rodrigo-olaya/smart-home-stm32/hardware/stm32_carrier_board/fab/render_bottom.png

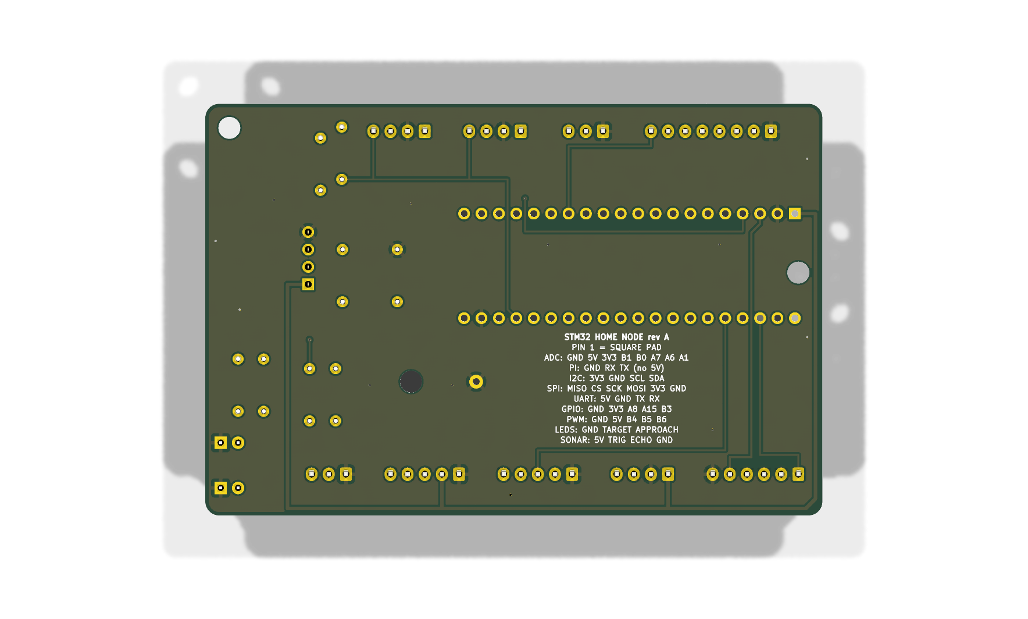
hardware/stm32_carrier_board/fab/render_bottom.png
