rodrigo-olaya/smart-home-stm32/hardware/stm32_carrier_board/fab/render_top.png

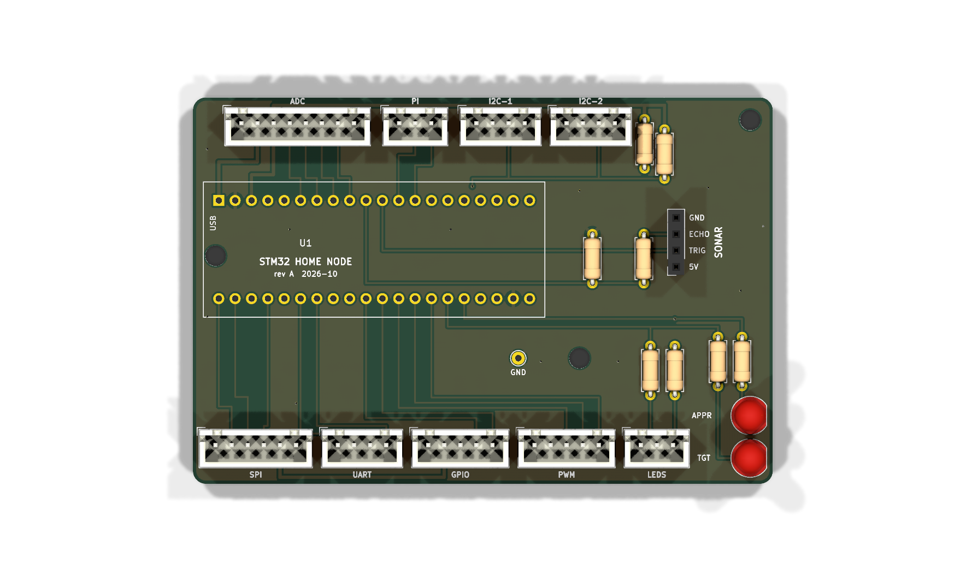
hardware/stm32_carrier_board/fab/render_top.png
