rodrigo-olaya/smart-home-stm32/hardware/stm32_carrier_board/fab/bom.csv

Reference | Value | Footprint | QUANTITY
D1 | TARGET | LED_THT:LED_D5.0mm | 1
D2 | APPROACH | LED_THT:LED_D5.0mm | 1
J1 | ADC | Connector_JST:JST_XH_B8B-XH-A_1x08_P2.50mm_Vertical | 1
J2 | SONAR | Connector_PinSocket_2.54mm:PinSocket_1x04_P2.54mm_Vertical | 1
J3 | PI | Connector_JST:JST_XH_B3B-XH-A_1x03_P2.50mm_Vertical | 1
J4 | I2C-1 | Connector_JST:JST_XH_B4B-XH-A_1x04_P2.50mm_Vertical | 1
J5 | I2C-2 | Connector_JST:JST_XH_B4B-XH-A_1x04_P2.50mm_Vertical | 1
J6 | SPI | Connector_JST:JST_XH_B6B-XH-A_1x06_P2.50mm_Vertical | 1
J7 | UART | Connector_JST:JST_XH_B4B-XH-A_1x04_P2.50mm_Vertical | 1
J8 | GPIO | Connector_JST:JST_XH_B5B-XH-A_1x05_P2.50mm_Vertical | 1
J9 | PWM | Connector_JST:JST_XH_B5B-XH-A_1x05_P2.50mm_Vertical | 1
J10 | LEDS | Connector_JST:JST_XH_B3B-XH-A_1x03_P2.50mm_Vertical | 1
R1,R2 | 4.7k | Resistor_THT:R_Axial_DIN0207_L6.3mm_D2.5mm_P7.62mm_Horizontal | 2
R3 | 1k | Resistor_THT:R_Axial_DIN0207_L6.3mm_D2.5mm_P7.62mm_Horizontal | 1
R4 | 2k | Resistor_THT:R_Axial_DIN0207_L6.3mm_D2.5mm_P7.62mm_Horizontal | 1
R5-R8 | 220 | Resistor_THT:R_Axial_DIN0207_L6.3mm_D2.5mm_P7.62mm_Horizontal | 4
U1 | WeAct_BlackPill_F411CE | stm32_board_fp:WeAct_BlackPill_Socket | 1
