rodrigo-olaya/smart-home-stm32/hardware/stm32_carrier_board/fab/schematic.pdf

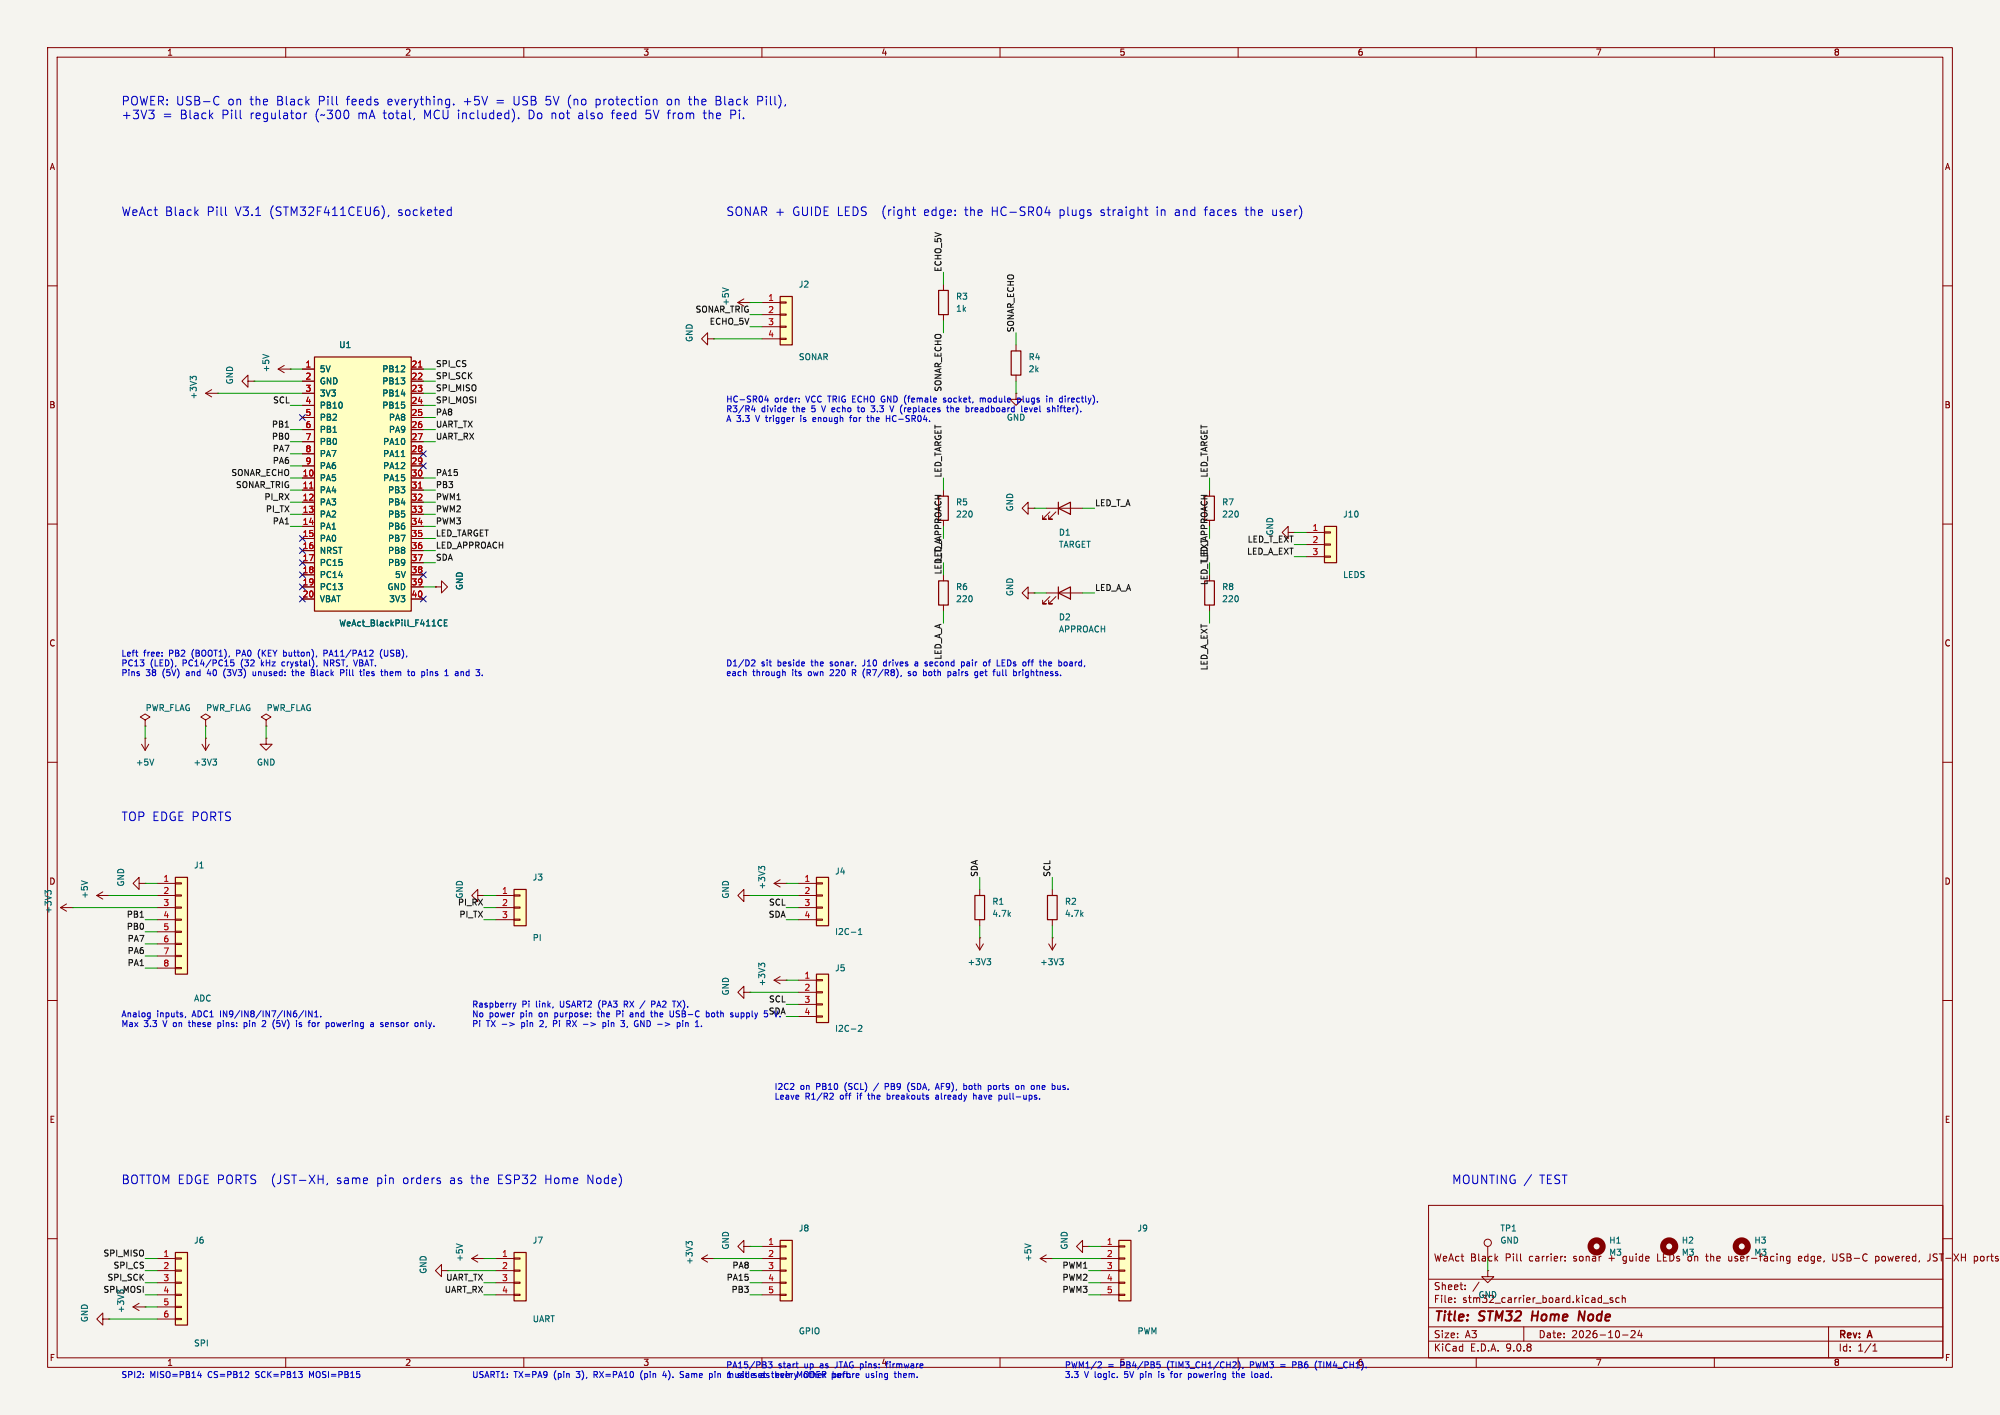
[picture p3: page 1]

BOTTOM EDGE PORTS (JST-XH, same pin orders as the ESP32 Home Node)

Id: 1/1 Title: STM32 Home Node

SPI2: MISO=PB14 CS=PB12 SCK=PB13 MOSI=PB15

USART1: TX=PA9 (pin 3), RX=PA10 (pin 4). Same pin 1 side as every other port.
