rodrigo-olaya/smart-home-stm32/hardware/stm32_carrier_board/stm32_carrier_board.kicad_pcb

## KiCad design hardware/stm32_carrier_board/stm32_carrier_board.kicad_pcb (2026-11-09)

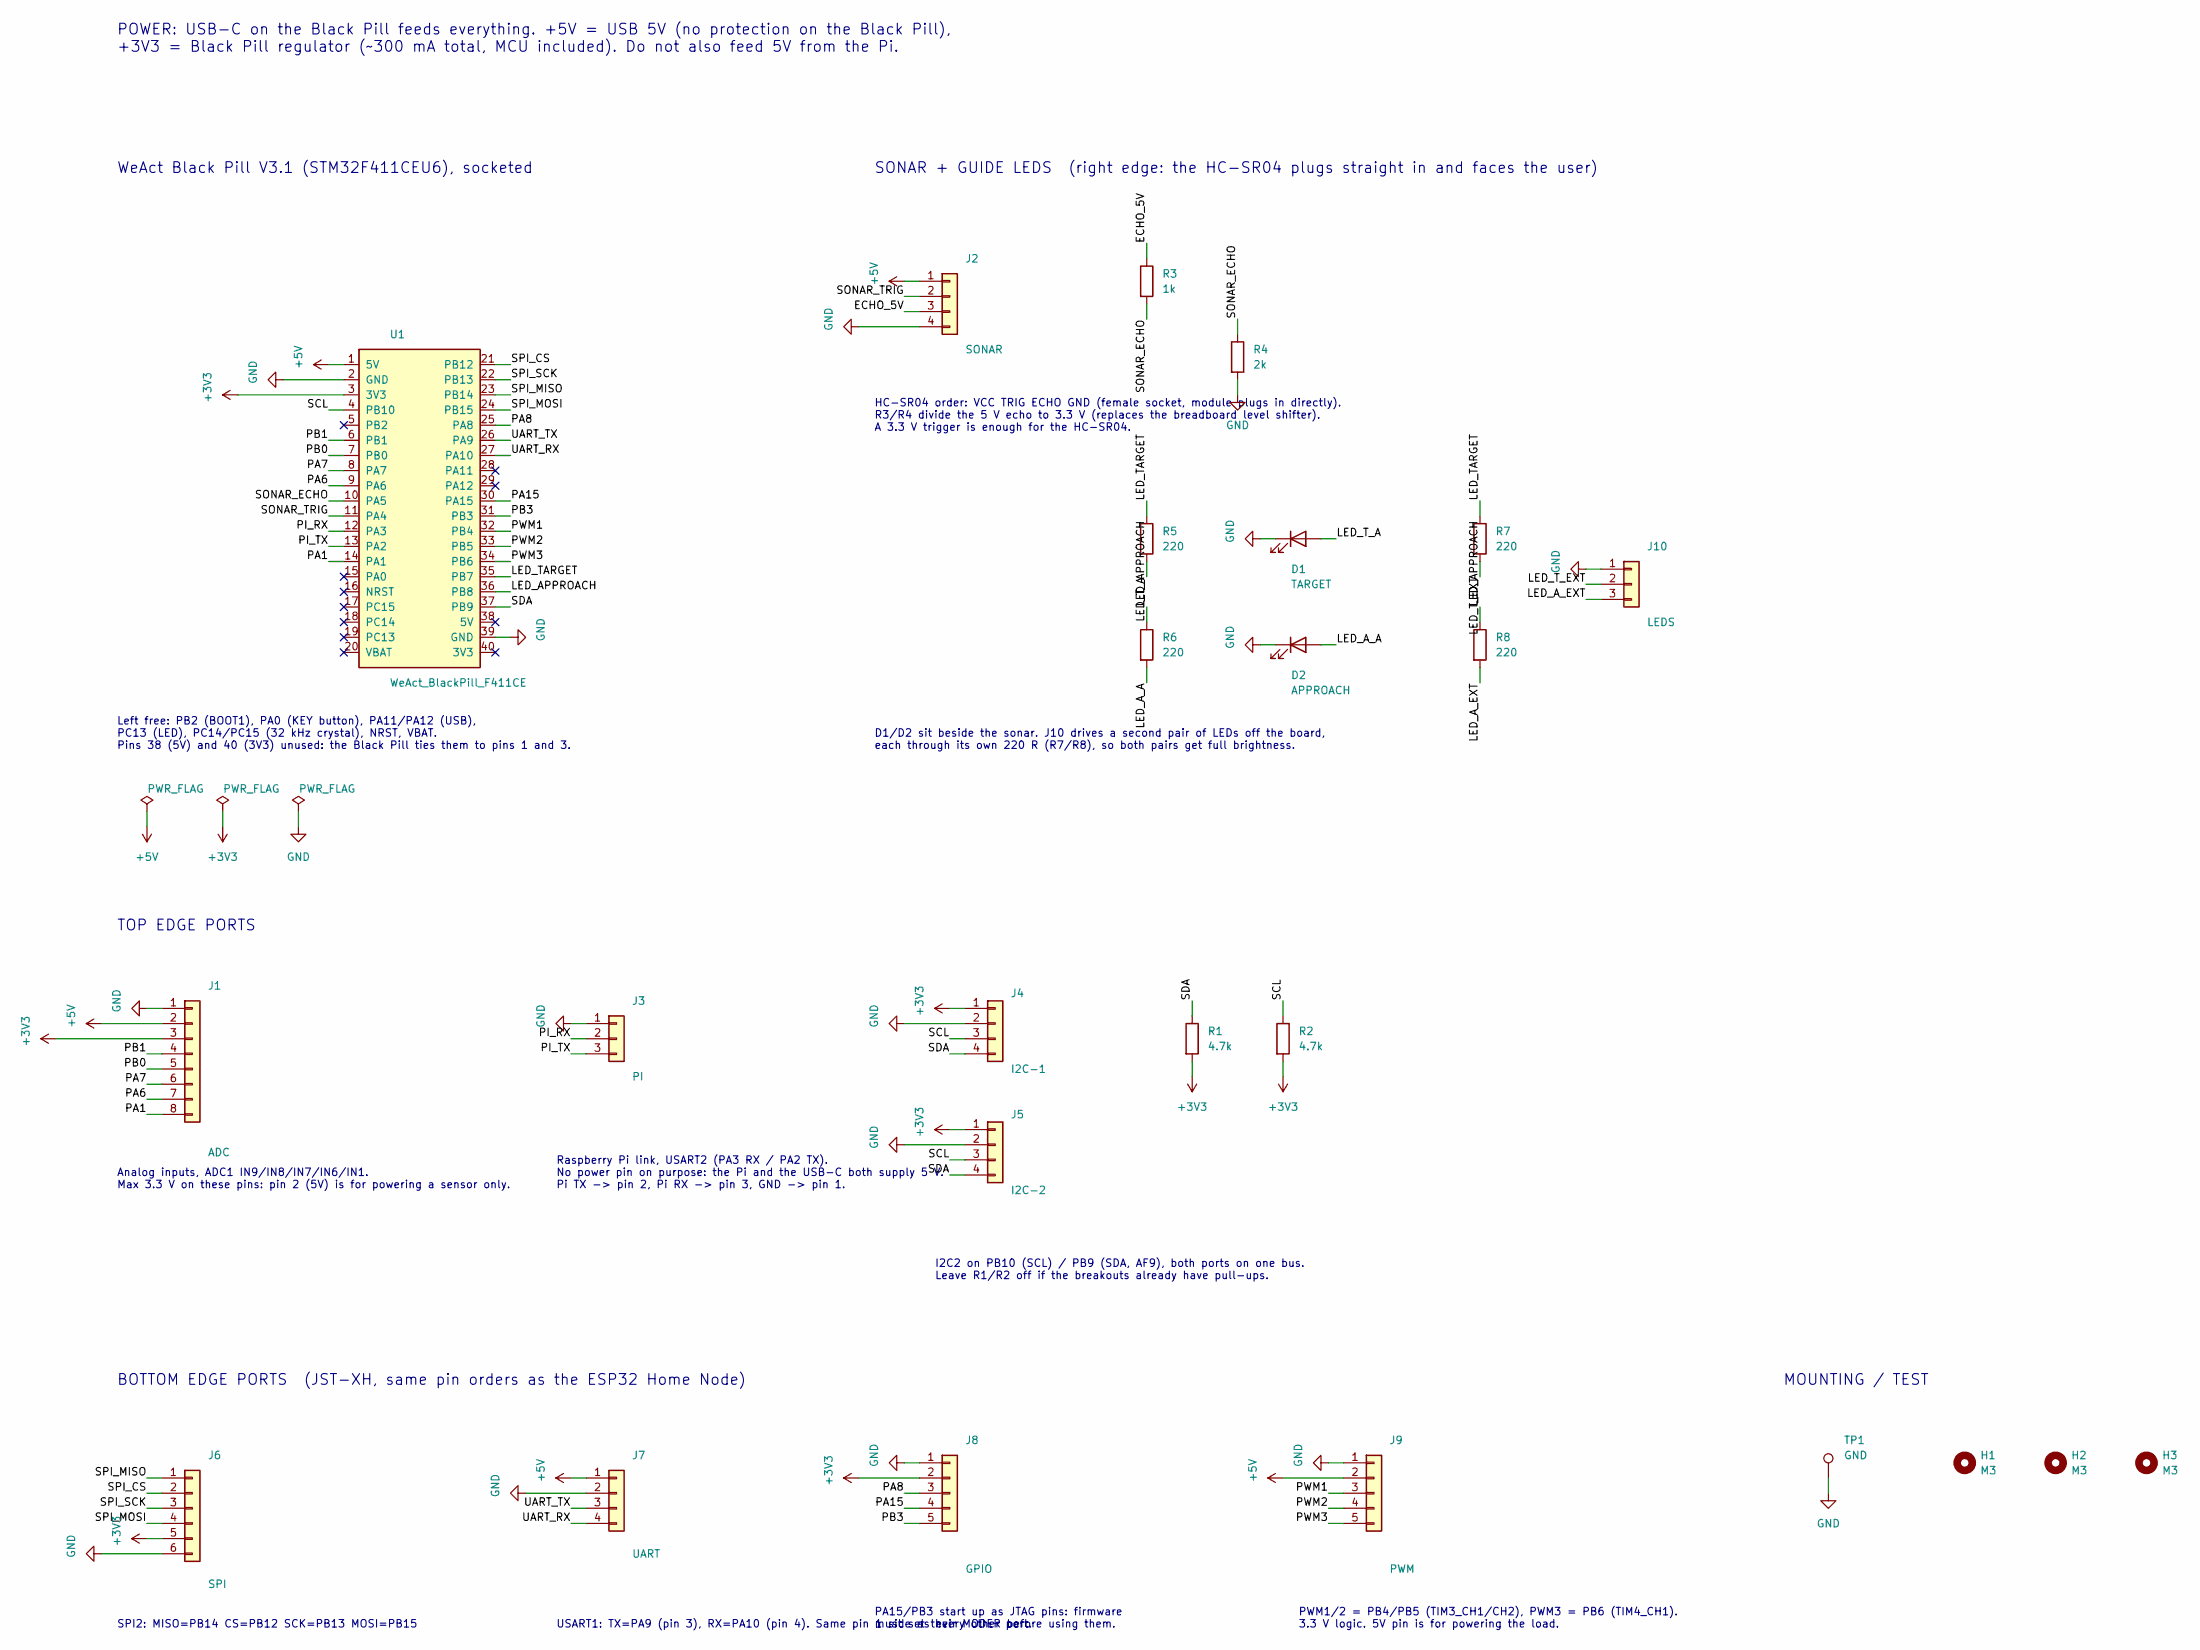
[picture p4: schematic stm32_carrier_board.kicad_sch, STM32 Home Node]

Parts:
D1: TARGET; LED_D5.0mm
D2: APPROACH; LED_D5.0mm
H1, H2, H3: M3; MountingHole_3.2mm_M3
J1: ADC; JST_XH_B8B-XH-A_1x08_P2.50mm_Vertical
J2: SONAR; PinSocket_1x04_P2.54mm_Vertical
J3: PI; JST_XH_B3B-XH-A_1x03_P2.50mm_Vertical
J4: I2C-1; JST_XH_B4B-XH-A_1x04_P2.50mm_Vertical
J5: I2C-2; JST_XH_B4B-XH-A_1x04_P2.50mm_Vertical
J6: SPI; JST_XH_B6B-XH-A_1x06_P2.50mm_Vertical
J7: UART; JST_XH_B4B-XH-A_1x04_P2.50mm_Vertical
J8: GPIO; JST_XH_B5B-XH-A_1x05_P2.50mm_Vertical
J9: PWM; JST_XH_B5B-XH-A_1x05_P2.50mm_Vertical
J10: LEDS; JST_XH_B3B-XH-A_1x03_P2.50mm_Vertical
R1, R2: 4.7k; R_Axial_DIN0207_L6.3mm_D2.5mm_P7.62mm_Horizontal
R3: 1k; R_Axial_DIN0207_L6.3mm_D2.5mm_P7.62mm_Horizontal
R4: 2k; R_Axial_DIN0207_L6.3mm_D2.5mm_P7.62mm_Horizontal
R5, R6, R7, R8: 220; R_Axial_DIN0207_L6.3mm_D2.5mm_P7.62mm_Horizontal
TP1: GND; TestPoint_THTPad_D2.0mm_Drill1.0mm
U1: WeAct_BlackPill_F411CE; WeAct_BlackPill_Socket

Connections:
+3V3: J1.3, J4.1, J5.1, J6.5, J8.2, R1.2, R2.2, U1.3 (3V3)
+5V: J1.2, J2.1, J7.1, J9.2, U1.1 (5V)
/ECHO_5V: J2.3, R3.1
/LED_APPROACH: R6.1, R8.1, U1.36 (PB8)
/LED_A_A: D2.2 (A), R6.2
/LED_A_EXT: J10.3, R8.2
/LED_TARGET: R5.1, R7.1, U1.35 (PB7)
/LED_T_A: D1.2 (A), R5.2
/LED_T_EXT: J10.2, R7.2
/PA1: J1.8, U1.14 (PA1)
/PA6: J1.7, U1.9 (PA6)
/PA7: J1.6, U1.8 (PA7)
/PA8: J8.3, U1.25 (PA8)
/PA15: J8.4, U1.30 (PA15)
/PB0: J1.5, U1.7 (PB0)
/PB1: J1.4, U1.6 (PB1)
/PB3: J8.5, U1.31 (PB3)
/PI_RX: J3.2, U1.12 (PA3)
/PI_TX: J3.3, U1.13 (PA2)
/PWM1: J9.3, U1.32 (PB4)
/PWM2: J9.4, U1.33 (PB5)
/PWM3: J9.5, U1.34 (PB6)
/SCL: J4.3, J5.3, R2.1, U1.4 (PB10)
/SDA: J4.4, J5.4, R1.1, U1.37 (PB9)
/SONAR_ECHO: R3.2, R4.1, U1.10 (PA5)
/SONAR_TRIG: J2.2, U1.11 (PA4)
/SPI_CS: J6.2, U1.21 (PB12)
/SPI_MISO: J6.1, U1.23 (PB14)
/SPI_MOSI: J6.4, U1.24 (PB15)
/SPI_SCK: J6.3, U1.22 (PB13)
/UART_RX: J7.4, U1.27 (PA10)
/UART_TX: J7.3, U1.26 (PA9)
GND: D1.1 (K), D2.1 (K), J1.1, J2.4, J3.1, J4.2, J5.2, J6.6, J7.2, J8.1, J9.1, J10.1, R4.2, TP1.1, U1.2 (GND), U1.39 (GND)

Notes on the sheet:
POWER: USB-C on the Black Pill feeds everything. +5V = USB 5V (no protection on the Black Pill), +3V3 = Black Pill regulator (~300 mA total, MCU included). Do not also feed 5V from the Pi.
WeAct Black Pill V3.1 (STM32F411CEU6), socketed
Left free: PB2 (BOOT1), PA0 (KEY button), PA11/PA12 (USB), PC13 (LED), PC14/PC15 (32 kHz crystal), NRST, VBAT. Pins 38 (5V) and 40 (3V3) unused: the Black Pill ties them to pins 1 and 3.
SONAR + GUIDE LEDS (right edge: the HC-SR04 plugs straight in and faces the user)
HC-SR04 order: VCC TRIG ECHO GND (female socket, module plugs in directly). R3/R4 divide the 5 V echo to 3.3 V (replaces the breadboard level shifter). A 3.3 V trigger is enough for the HC-SR04.
D1/D2 sit beside the sonar. J10 drives a second pair of LEDs off the board, each through its own 220 R (R7/R8), so both pairs get full brightness.
TOP EDGE PORTS
Analog inputs, ADC1 IN9/IN8/IN7/IN6/IN1. Max 3.3 V on these pins: pin 2 (5V) is for powering a sensor only.
Raspberry Pi link, USART2 (PA3 RX / PA2 TX). No power pin on purpose: the Pi and the USB-C both supply 5 V. Pi TX -> pin 2, Pi RX -> pin 3, GND -> pin 1.
I2C2 on PB10 (SCL) / PB9 (SDA, AF9), both ports on one bus. Leave R1/R2 off if the breakouts already have pull-ups.
BOTTOM EDGE PORTS (JST-XH, same pin orders as the ESP32 Home Node)
SPI2: MISO=PB14 CS=PB12 SCK=PB13 MOSI=PB15
USART1: TX=PA9 (pin 3), RX=PA10 (pin 4). Same pin 1 side as every other port.
PA15/PB3 start up as JTAG pins: firmware must set their MODER before using them.
PWM1/2 = PB4/PB5 (TIM3_CH1/CH2), PWM3 = PB6 (TIM4_CH1). 3.3 V logic. 5V pin is for powering the load.
MOUNTING / TEST

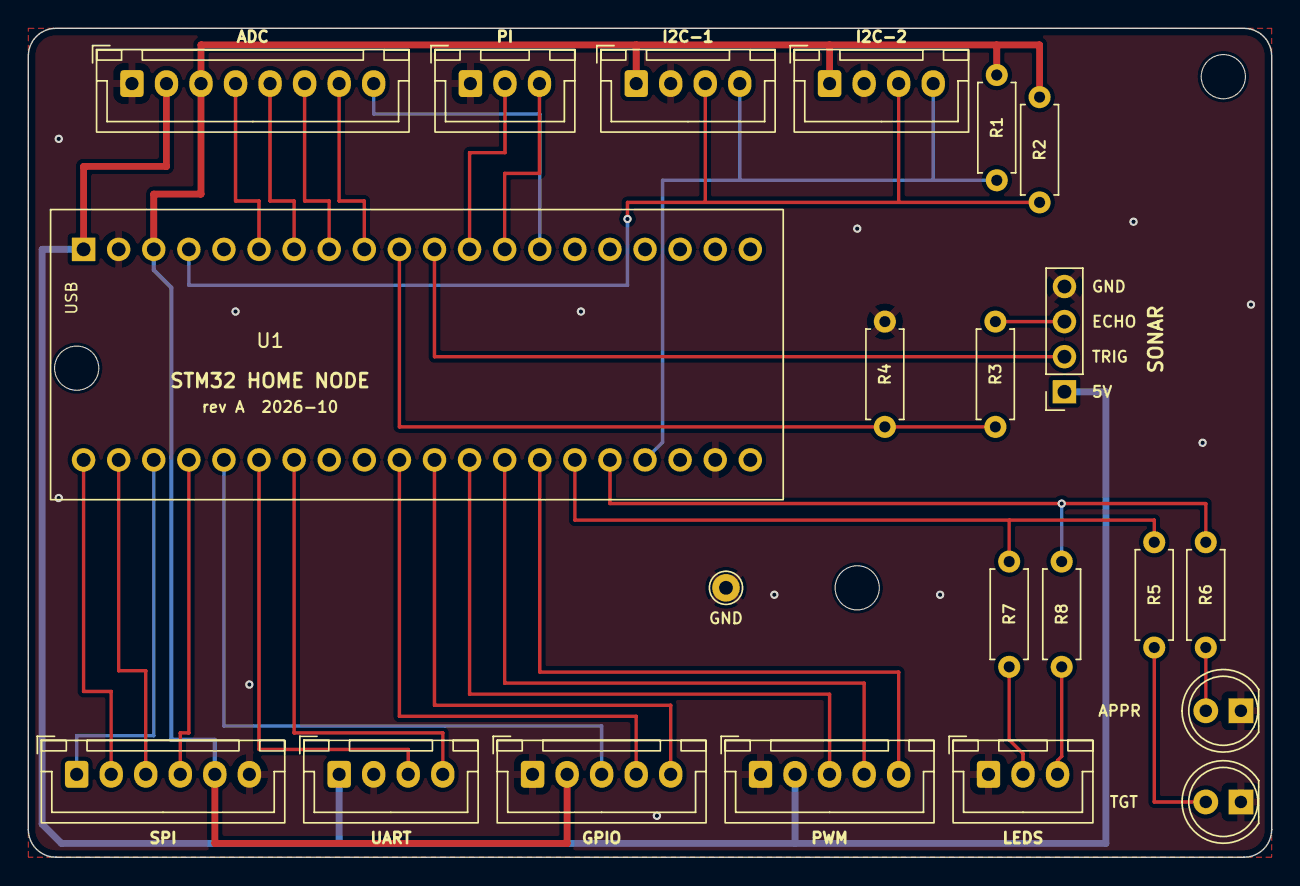
[picture p5: board stm32_carrier_board.kicad_pcb from above]

Board: 2 copper layers, 90.0 x 60.0 mm, 25 parts (0 on the bottom side), 33 nets.
