rodrigo-olaya/smart-home-stm32/src/drivers/sonar/sonar.h

#ifndef SONAR_H
#define SONAR_H

#include "../registers.h"
#include "../gpio/gpio.h"
#include "../timers/timer.h"
#include "../uart/uart.h"

#define TRIG_PIN 4
#define ECHO_PIN 5

extern volatile uint32_t preSoundStart;
extern volatile uint32_t soundStart;
extern volatile uint32_t elapsedTime;
extern volatile uint8_t ready;
extern volatile uint8_t waitingForFallingEdge;
extern volatile uint32_t lastSonarTrigger;

void sonarInit();

void triggerSonar();

void handleEcho(uint8_t dir);

uint16_t readSonar();

uint16_t handleSonar();

#endif
