rodrigo-olaya/smart-home-stm32/src/drivers/timers/timer.h

#ifndef TIMER_H
#define TIMER_H

#include <stdint.h>
#include "../registers.h"

typedef struct {
    volatile uint32_t CR1;
    volatile uint32_t CR2;
    volatile uint32_t SMCR;
    volatile uint32_t DIER;
    volatile uint32_t SR;
    volatile uint32_t EGR;
    volatile uint32_t CCMR1;
    volatile uint32_t CCMR2;
    volatile uint32_t CCER;
    volatile uint32_t CNT;
    volatile uint32_t PSC;
    volatile uint32_t ARR;
    volatile uint32_t RCR;
    volatile uint32_t CCR1;
    volatile uint32_t CCR2;
    volatile uint32_t CCR3;
    volatile uint32_t CCR4;
    volatile uint32_t BDTR;
    volatile uint32_t DCR;
    volatile uint32_t DMAR;
    volatile uint32_t TIM2_OR;
} TIM_RegDef_t;

#define NVIC_TIM2_POSITION 28
#define TIM2_EN 0
#define TIM3_EN 1
#define TIM4_EN 2

#define pTIM2 ((TIM_RegDef_t*)0x40000000)
#define pTIM3 ((TIM_RegDef_t*)0x40000400)
#define pTIM4 ((TIM_RegDef_t*)0x40000800)

#define TIM2_ARR 1000
#define TIM2_PSC 15
#define TIM2_UIE 0
#define TIM2_CEN 0
#define TIM2_UIF 0

#define TIM3_ARR 65535
#define TIM3_PSC 15
#define TIM3_CEN 0
#define TIM3_UIF 0

extern volatile uint32_t tick;

void initTimers();

void tim2Handler();

uint32_t elapsedUs(uint32_t start);

#endif
