rodrigo-olaya/smart-home-stm32/src/drivers/timers/timer.c

#include "timer.h"

volatile uint32_t tick;


void initTimers() {
    pRCC->APB1ENR |= (0x01 << TIM2_EN);
    pRCC->APB1ENR |= (0x01 << TIM3_EN);
    *NVIC_ISER0 |= (0x01 << NVIC_TIM2_POSITION);

    pTIM2->ARR = TIM2_ARR;
    pTIM2->PSC = TIM2_PSC;

    pTIM2->DIER |= (0x01 << TIM2_UIE);
    pTIM2->CR1 |= (0x01 << TIM2_CEN);

    pTIM3->ARR = TIM3_ARR;
    pTIM3->PSC = TIM3_PSC;
    pTIM3->CR1 |= (0x01 << TIM3_CEN);
}

void tim2Handler() {
    pTIM2->SR &= ~(0x01 << TIM2_UIF);
    tick++;
}

uint32_t elapsedUs(uint32_t start) {
    uint32_t current = pTIM3->CNT;
    if (start > current) {
        return current + (pTIM3->ARR + 1) - start;
    }
    else{
        return current - start;
    }
}
