rodrigo-olaya/smart-home-stm32/(commit log)

2026-06-19 uart registers
2026-06-19 UART init
2026-06-20 uart write byte
2026-06-21 UART working on logic analyzer
2026-06-24 UART working on logic analyzer and pi
2026-06-27 start intitializing timers
2026-06-27 finish C implementation of timers
2026-06-28 uart dequeue
2026-06-28 UART ISR
2026-07-24 start uart RX
2026-08-09 sonar init
2026-08-09 start writing read sonar
2026-08-09 presence sensor tested on la and gdb
2026-08-23 Interrupt-driven sonar working
2026-08-23 interrupt driven sonar fully working on pi
2026-10-18 pwm init
2026-10-18 approach and target leds working
2026-10-18 sonar to leds
2026-11-09 pcb v1
